timdrysdale/experiment-truss-type1/(commit log)

2021-06-28 added an initial design of the circuit schematic, as well as simple tests of gauge measurements and Arduino communication
2021-06-28 added schematic to readme
